theodorehadges/diy-ventilator-challenge/README.md

# Columbia Engineering Design Challenge: DIY Ventilators for COVID-19

Working with a diverse team of 6 students from 5 different universities, 
we were tasked with designing a DIY solution to the global ventilator shortage problem. 

<hr>
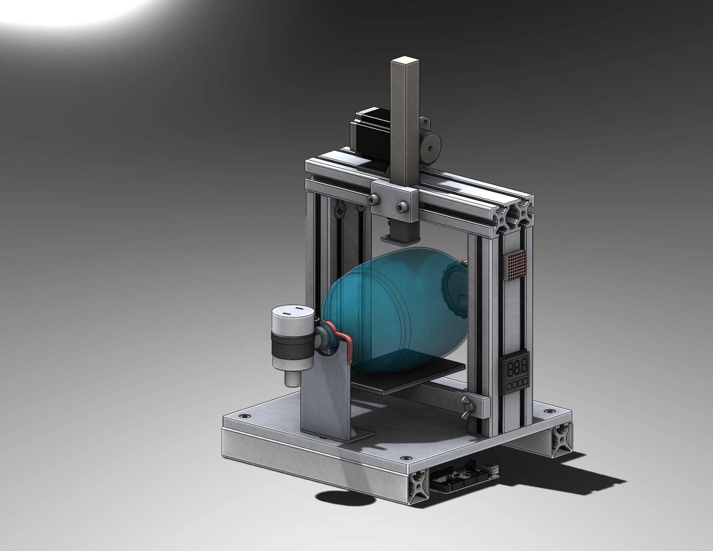
[picture p1: media/arbor_vent_realview.PNG]
   

**Figure 1:** Our ventilator design, the *Arbor Vent*, inspired by the mechanics of an Arbor Press, 
is a rack-and-pinion-based squeezing tool which emulates the dynamics of a human hand squeezing a Bag Valve Mask (BVM).
It has a single point of contact on top (like a thumb) and a flat surface on bottom (like a palm).  

<hr>

#### [View Design Proposal](https://github.com/theodorehadges/diy-ventilator-challenge/blob/master/media/design-proposal.pdf)  

<hr>

## Some cool videos

Rotating Arbor Vent   
**Figure 2:** A neat animation of our design.

<hr>

Subtitled Vent  
**Figure 3:** A subtitled video annotating some of the Arbor Vent's key features.

<hr>

Control Panel  
**Figure 4:** A control panel prototype showing how doctors/nurses may select BVM and frequency parameters.
