theodorehadges/diy-ventilator-challenge/docs/brainstorm.pdf

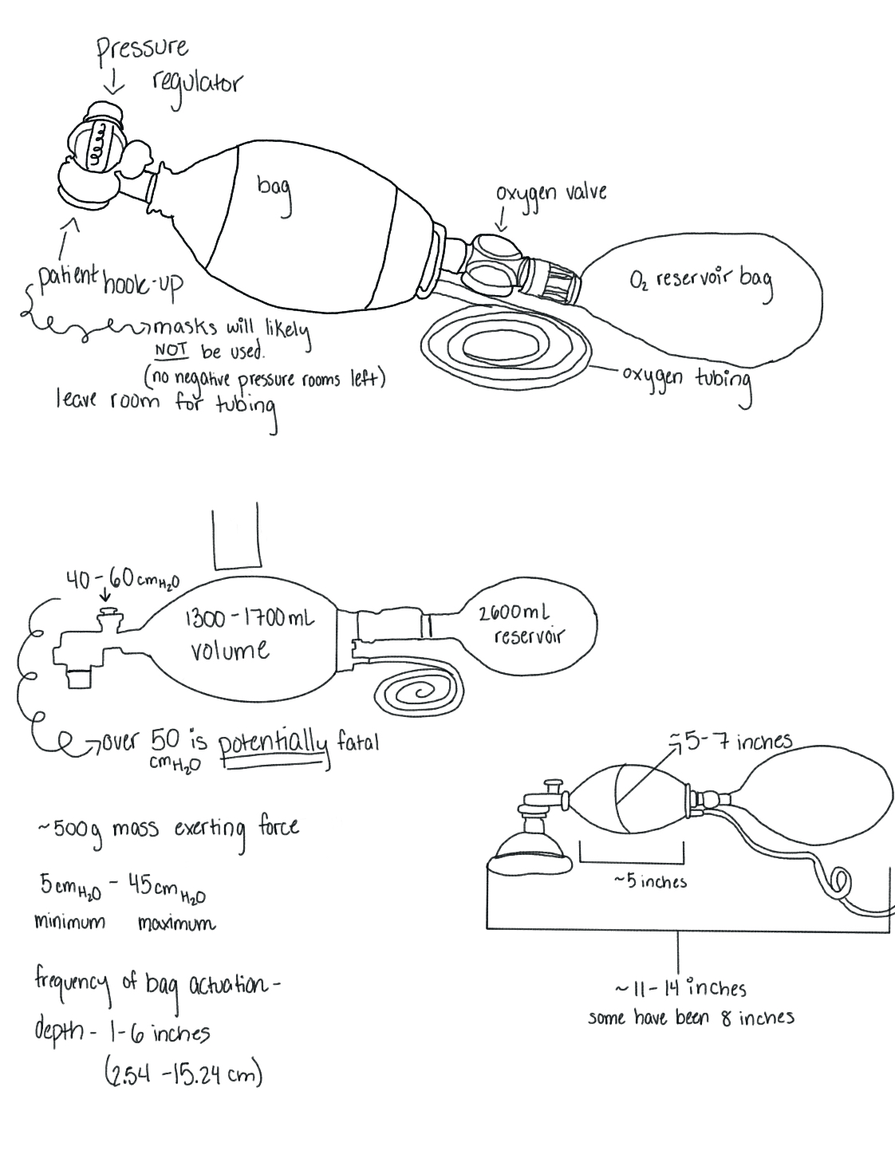
[picture p10: page 1]
