theodorehadges/diy-ventilator-challenge/docs/codeflow.pdf

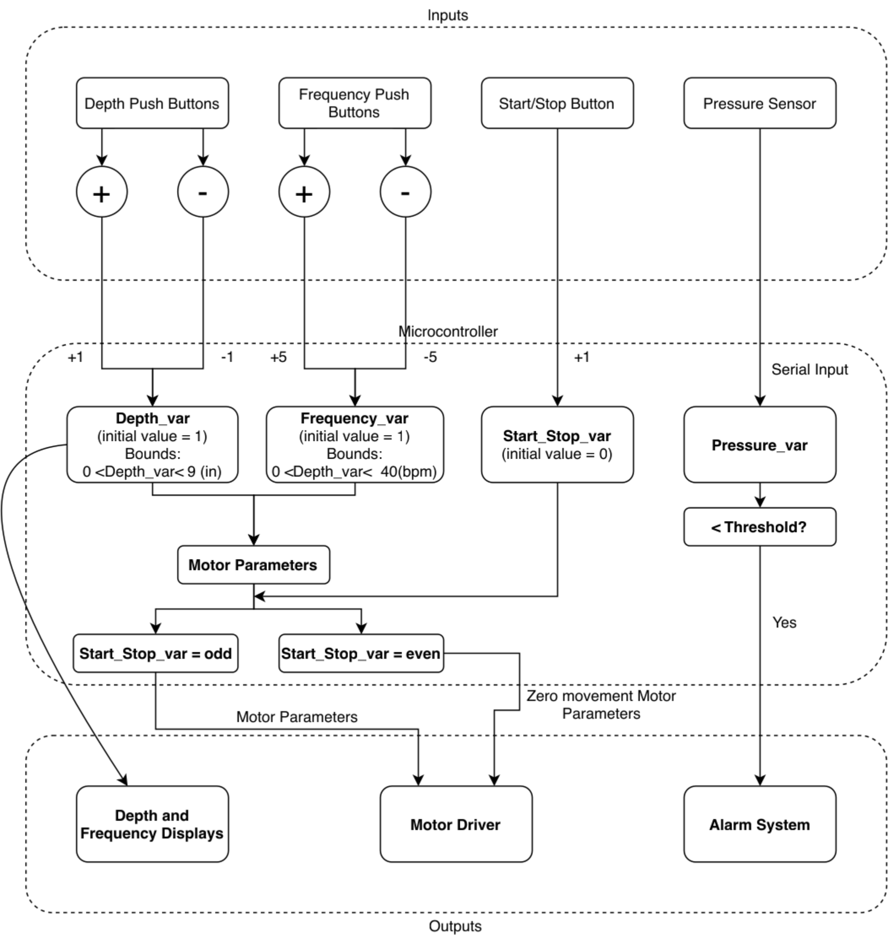
[picture p11: figure]
