theodorehadges/diy-ventilator-challenge/docs/drawings/3_view_arbor_vent_assy.PNG

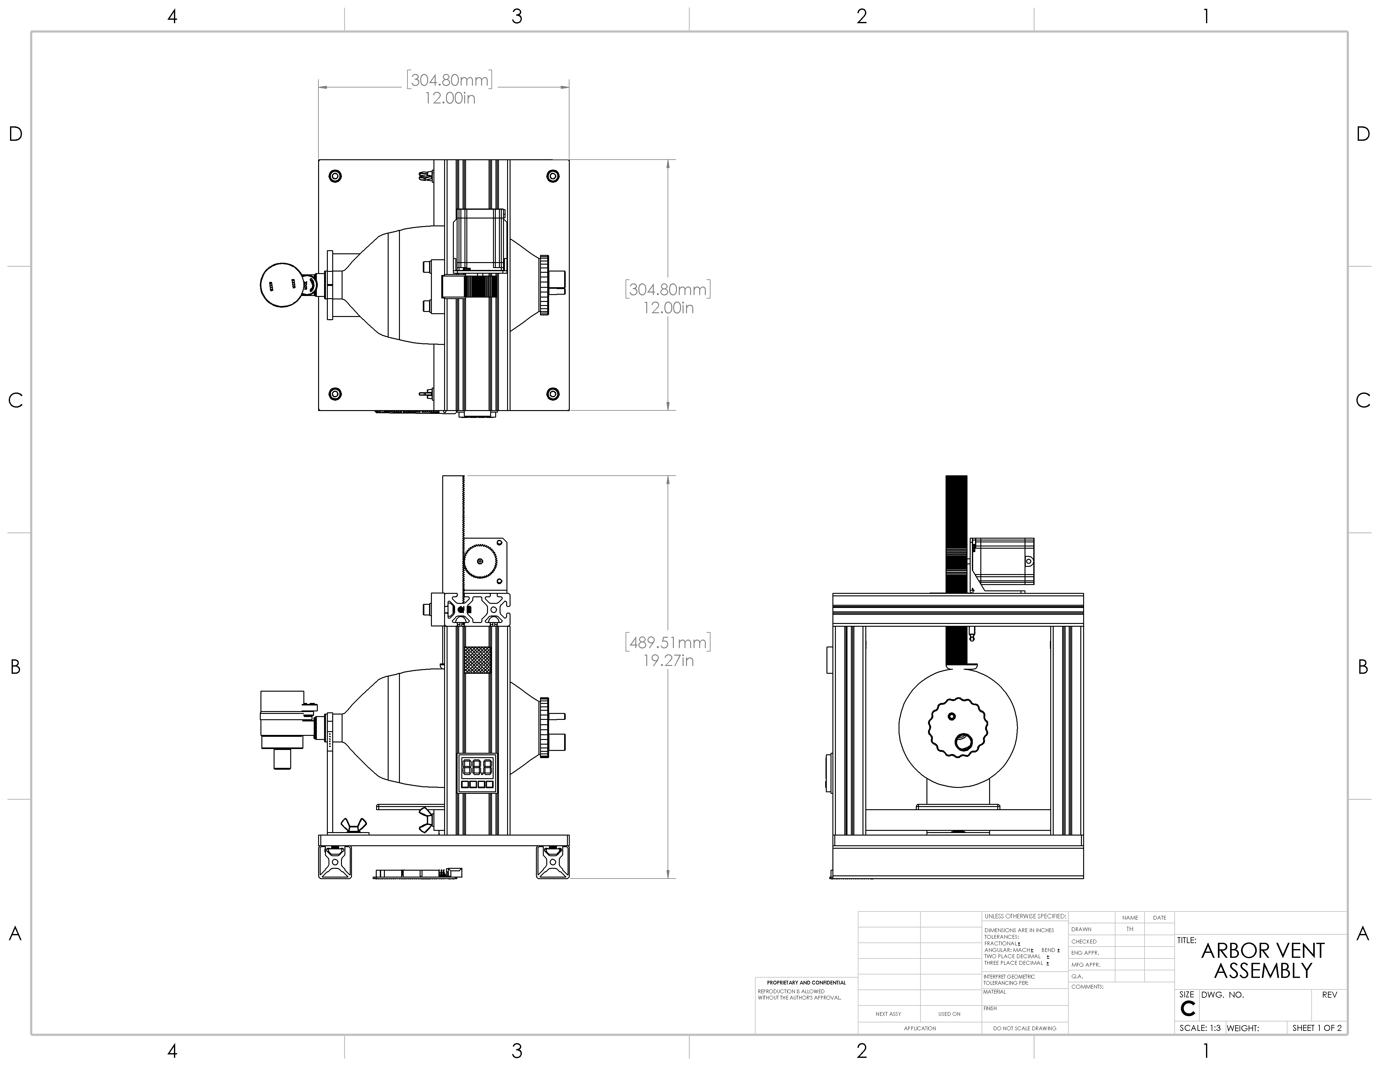
docs/drawings/3_view_arbor_vent_assy.PNG
