theodorehadges/diy-ventilator-challenge/docs/drawings/circuit-diagram.png

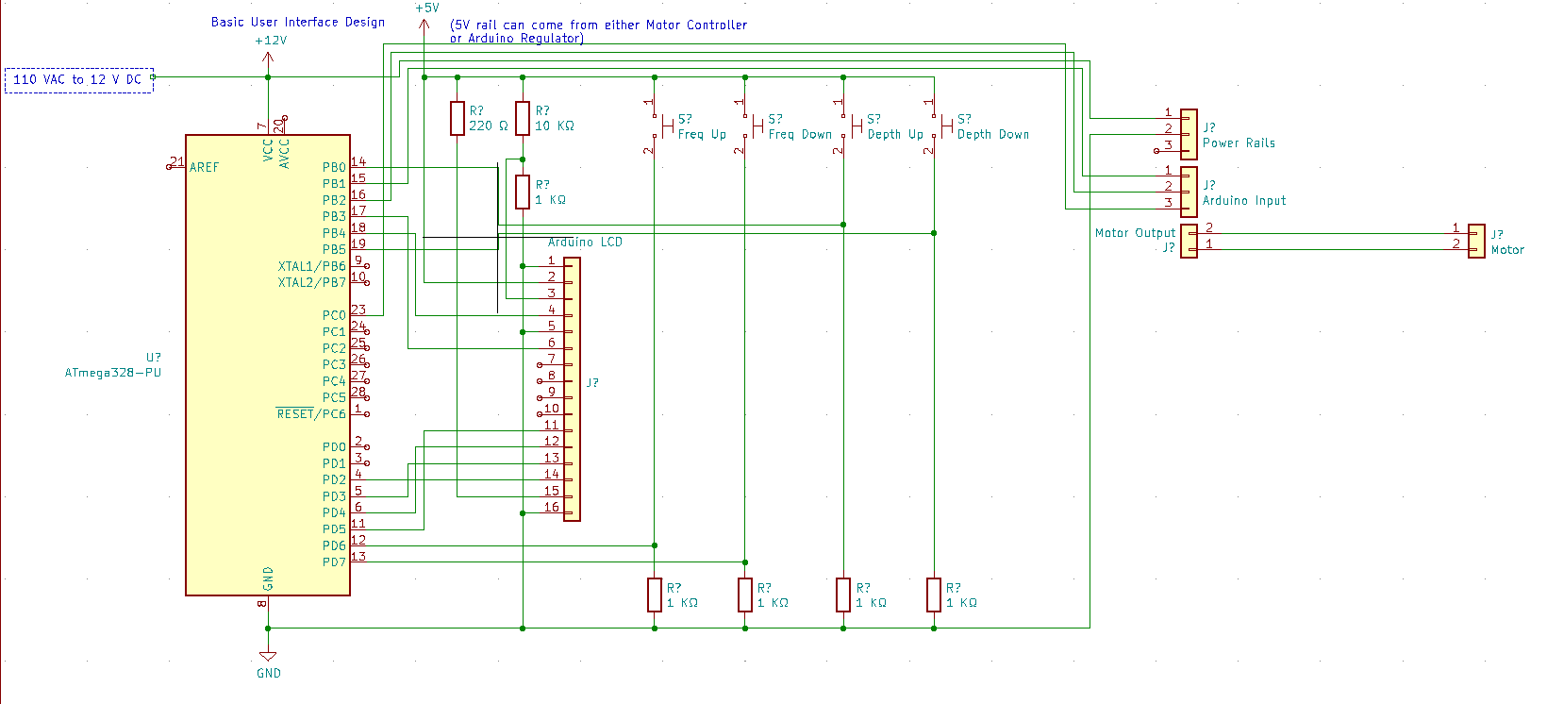
docs/drawings/circuit-diagram.png
