theodorehadges/diy-ventilator-challenge/docs/drawings/bom_arbor_vent_assy.PNG

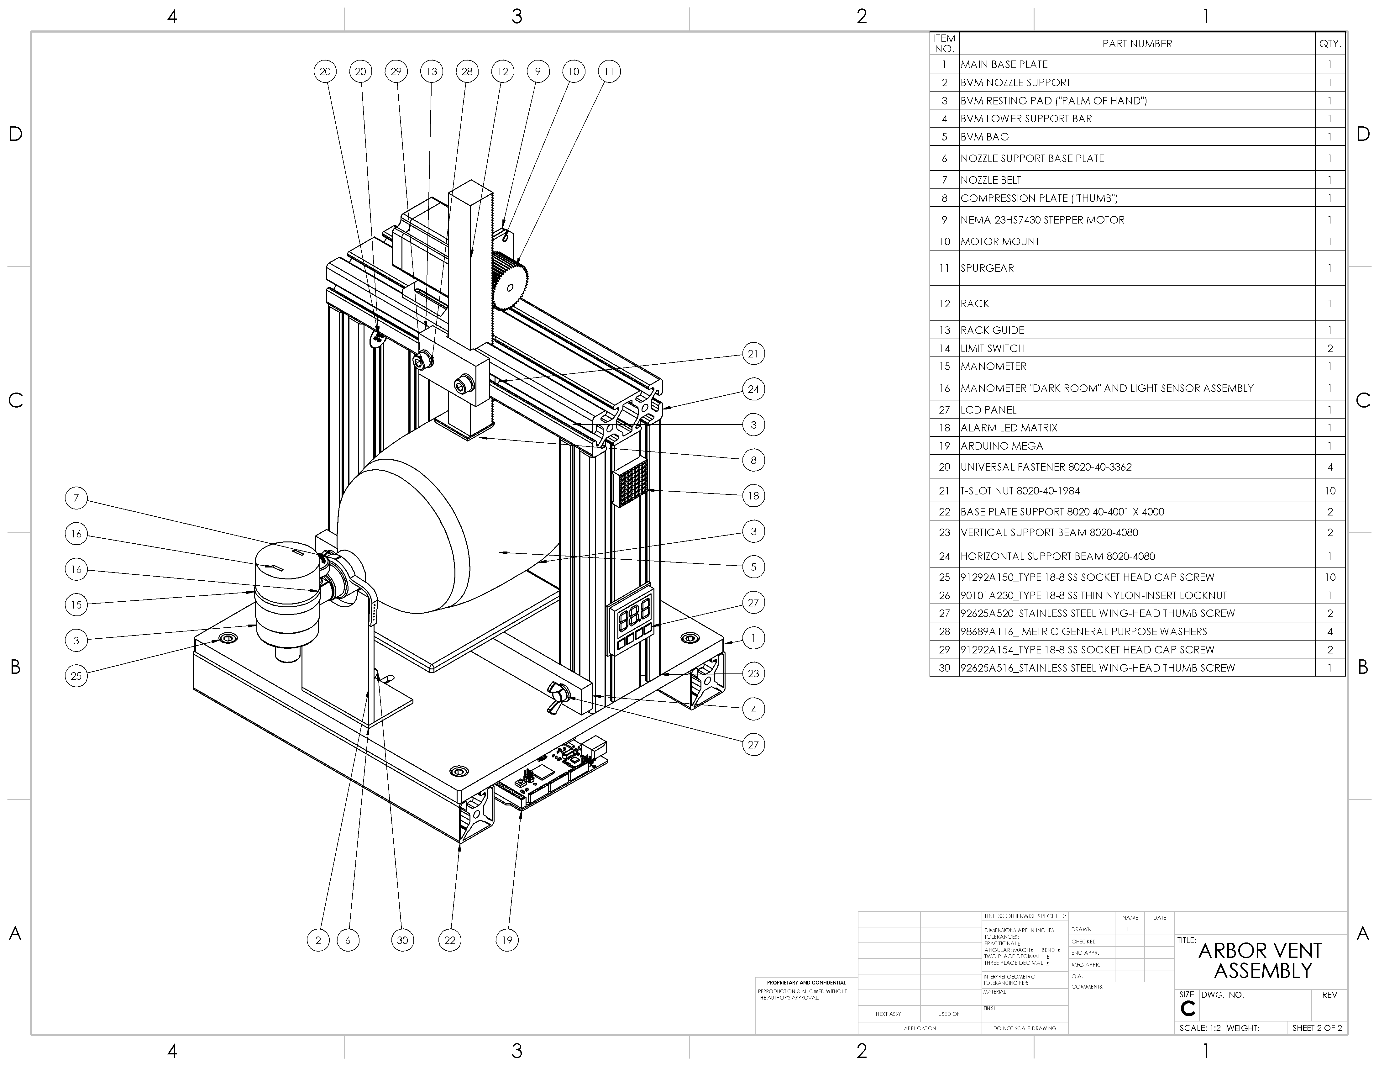
docs/drawings/bom_arbor_vent_assy.PNG
